Levvroy/LevvDeck/levvdeck-connections.md

# LevvDeck — Connections & Footprints

> Auto-generated by `gen_connections.py` from the shared data block in `gen_netlist.py`. Do not edit by hand — edit the data block and regenerate. The ESP32 pinout here is identical to the `#define`s in `firmware.ino`.

## ESP32 pinout (locked)

| Function | GPIO |
|---|---|
| I2C SDA | IO21 |
| I2C SCL | IO22 |
| Matrix ROW0/1/2 | IO13 / IO14 / IO27 |
| Matrix COL0/1/2 | IO26 / IO25 / IO33 |
| Encoder1 A/B/SW | IO16 / IO17 / IO4 |
| Encoder2 A/B/SW | IO32 / IO18 / IO19 |
| WS2812 DATA | IO23 (via R1) |
| Power | 3V3->OLED VCC, 5V(VIN)->WS2812 VDD, GND common |

## Components / footprints (25 total)

| Ref | Value | Footprint |
|---|---|---|
| D1 | 1N4148 | `Diode_THT:D_DO-35_SOD27_P7.62mm_Horizontal` |
| D2 | 1N4148 | `Diode_THT:D_DO-35_SOD27_P7.62mm_Horizontal` |
| D3 | 1N4148 | `Diode_THT:D_DO-35_SOD27_P7.62mm_Horizontal` |
| D4 | 1N4148 | `Diode_THT:D_DO-35_SOD27_P7.62mm_Horizontal` |
| D5 | 1N4148 | `Diode_THT:D_DO-35_SOD27_P7.62mm_Horizontal` |
| D6 | 1N4148 | `Diode_THT:D_DO-35_SOD27_P7.62mm_Horizontal` |
| D7 | 1N4148 | `Diode_THT:D_DO-35_SOD27_P7.62mm_Horizontal` |
| D8 | 1N4148 | `Diode_THT:D_DO-35_SOD27_P7.62mm_Horizontal` |
| D9 | 1N4148 | `Diode_THT:D_DO-35_SOD27_P7.62mm_Horizontal` |
| J1 | OLED_I2C | `Connector_PinHeader_2.54mm:PinHeader_1x04_P2.54mm_Vertical` |
| LED1 | WS2812B | `LED_SMD:LED_WS2812B_PLCC4_5.0x5.0mm_P3.2mm` |
| LED2 | WS2812B | `LED_SMD:LED_WS2812B_PLCC4_5.0x5.0mm_P3.2mm` |
| R1 | 330 | `Resistor_THT:R_Axial_DIN0207_L6.3mm_D2.5mm_P10.16mm_Horizontal` |
| RV1 | EC11 | `Rotary_Encoder:RotaryEncoder_Alps_EC11E-Switch_Vertical_H20mm` |
| RV2 | EC11 | `Rotary_Encoder:RotaryEncoder_Alps_EC11E-Switch_Vertical_H20mm` |
| SW1 | MX | `Button_Switch_Keyboard:SW_Cherry_MX_1.00u_PCB` |
| SW2 | MX | `Button_Switch_Keyboard:SW_Cherry_MX_1.00u_PCB` |
| SW3 | MX | `Button_Switch_Keyboard:SW_Cherry_MX_1.00u_PCB` |
| SW4 | MX | `Button_Switch_Keyboard:SW_Cherry_MX_1.00u_PCB` |
| SW5 | MX | `Button_Switch_Keyboard:SW_Cherry_MX_1.00u_PCB` |
| SW6 | MX | `Button_Switch_Keyboard:SW_Cherry_MX_1.00u_PCB` |
| SW7 | MX | `Button_Switch_Keyboard:SW_Cherry_MX_1.00u_PCB` |
| SW8 | MX | `Button_Switch_Keyboard:SW_Cherry_MX_1.00u_PCB` |
| SW9 | MX | `Button_Switch_Keyboard:SW_Cherry_MX_1.00u_PCB` |
| U1 | ESP32-DevKitC | `LevvDeck:ESP32_DevKitC_38P_Socket` |

## Matrix (3x3, COL2ROW)

Per key: `SWx.pad1 -> COLn`, `SWx.pad2 -> Dx anode (pad2)`, `Dx cathode (pad1) -> ROWn`.

```
        COL0      COL1      COL2
ROW0    SW1/D1    SW2/D2    SW3/D3
ROW1    SW4/D4    SW5/D5    SW6/D6
ROW2    SW7/D7    SW8/D8    SW9/D9
```

## Nets (29 signal)

| # | Net | Nodes (ref.pad) |
|---|---|---|
| 1 | `+3V3` | U1.3V3, J1.2 |
| 2 | `+5V` | U1.5V, LED1.1, LED2.1 |
| 3 | `GND` | U1.GND, RV1.C, RV1.S2, RV1.MP, RV2.C, RV2.S2, RV2.MP, J1.1, LED1.3, LED2.3 |
| 4 | `I2C_SDA` | U1.IO21, J1.4 |
| 5 | `I2C_SCL` | U1.IO22, J1.3 |
| 6 | `ROW0` | U1.IO13, D1.1, D2.1, D3.1 |
| 7 | `ROW1` | U1.IO14, D4.1, D5.1, D6.1 |
| 8 | `ROW2` | U1.IO27, D7.1, D8.1, D9.1 |
| 9 | `COL0` | U1.IO26, SW1.1, SW4.1, SW7.1 |
| 10 | `COL1` | U1.IO25, SW2.1, SW5.1, SW8.1 |
| 11 | `COL2` | U1.IO33, SW3.1, SW6.1, SW9.1 |
| 12 | `ENC1_A` | U1.IO16, RV1.A |
| 13 | `ENC1_B` | U1.IO17, RV1.B |
| 14 | `ENC1_SW` | U1.IO4, RV1.S1 |
| 15 | `ENC2_A` | U1.IO32, RV2.A |
| 16 | `ENC2_B` | U1.IO18, RV2.B |
| 17 | `ENC2_SW` | U1.IO19, RV2.S1 |
| 18 | `WS_DRIVE` | U1.IO23, R1.1 |
| 19 | `n_SW1_D1` | SW1.2, D1.2 |
| 20 | `n_SW2_D2` | SW2.2, D2.2 |
| 21 | `n_SW3_D3` | SW3.2, D3.2 |
| 22 | `n_SW4_D4` | SW4.2, D4.2 |
| 23 | `n_SW5_D5` | SW5.2, D5.2 |
| 24 | `n_SW6_D6` | SW6.2, D6.2 |
| 25 | `n_SW7_D7` | SW7.2, D7.2 |
| 26 | `n_SW8_D8` | SW8.2, D8.2 |
| 27 | `n_SW9_D9` | SW9.2, D9.2 |
| 28 | `WS_DIN1` | R1.2, LED1.4 |
| 29 | `WS_CHAIN1` | LED1.2, LED2.4 |

_Plus 19 `unconnected-(...)` stub nets — one per floating footprint pad (spare U1 GPIO + LED2 DOUT) — so KiCad's netlist import is warning-free._

## U1 — ESP32 DevKitC socket pad map

> 🛑 **HUMAN CHECK**: row spacing must be measured with calipers; verify this pad order matches YOUR DevKit silk. Footprint `LevvDeck:ESP32_DevKitC_38P_Socket`.

| Pin | Left label | Net | Pin | Right label | Net |
|---|---|---|---|---|---|
| 1 | 3V3 | +3V3 | 20 | GND | GND |
| 2 | EN | — | 21 | IO23 | WS_DRIVE |
| 3 | IO36 | — | 22 | IO22 | I2C_SCL |
| 4 | IO39 | — | 23 | IO1 | — |
| 5 | IO34 | — | 24 | IO3 | — |
| 6 | IO35 | — | 25 | IO21 | I2C_SDA |
| 7 | IO32 | ENC2_A | 26 | GND | GND |
| 8 | IO33 | COL2 | 27 | IO19 | ENC2_SW |
| 9 | IO25 | COL1 | 28 | IO18 | ENC2_B |
| 10 | IO26 | COL0 | 29 | IO5 | — |
| 11 | IO27 | ROW2 | 30 | IO17 | ENC1_B |
| 12 | IO14 | ROW1 | 31 | IO16 | ENC1_A |
| 13 | IO12 | — | 32 | IO4 | ENC1_SW |
| 14 | GND | GND | 33 | IO0 | — |
| 15 | IO13 | ROW0 | 34 | IO2 | — |
| 16 | IO9 | — | 35 | IO15 | — |
| 17 | IO10 | — | 36 | IO8 | — |
| 18 | IO11 | — | 37 | IO7 | — |
| 19 | 5V | +5V | 38 | IO6 | — |

## 🛑 HUMAN CHECK items before fabrication

1. **Diode polarity** — `Dx.pad1` is the **cathode** and must face the ROW net. (Footprint `Diode_THT:D_DO-35_SOD27_P7.62mm_Horizontal`, pad1=K.)
2. **OLED header J1 order** — default is GND/VCC/SCL/SDA (pins 1-4). Confirm against your module's silk; VCC/GND or SCL/SDA order may differ.
3. **EC11 pads** — A/B = quadrature, C = common to GND, S1/S2 = push switch. Confirm against the module.
4. **U1 row spacing + USB edge** — measured spacing, pad mapping, and USB-to-edge cutout all correct.

_WS2812 count: 2._
