Levvroy/LevvDeck/(commit log)

2026-06-30 Add LevvDeck PCB design-as-code pipeline
    Generate the full LevvDeck macropad design (ESP32 + 3x3 Cherry MX matrix,
    2x EC11 encoders, SSD1306 OLED, 2x WS2812B) as a reproducible KiCad pipeline
    the user runs on their KiCad 8/9 machine.
    Single source of truth (gen_netlist.py) drives:
    - levvdeck.net (25 footprints, 29 nets, 0 unresolved)
    - firmware.ino (#define pinout mirrors the netlist)
    - levvdeck-connections.md + levvdeck-BOM.csv
    - custom U1 ESP32-DevKitC socket footprint (parameterized row spacing)
    Pipeline scripts (build_board / place / route / export) + JLCPCB DRC rules,
    Makefile, and BUILD.md with the three HUMAN CHECK gates. Pad names verified
    against the official KiCad libs; corrected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
    [levvdeck-BOM.csv]
2026-07-02 Fix KiCad netlist import: resolve U1 lib + clean warnings
    Two issues surfaced when importing levvdeck.net via KiCad's GUI:
    1. U1 footprint not found. The custom LevvDeck lib is registered only in the
    project fp-lib-table (${KIPRJMOD}), which needs an open KiCad project. Add a
    minimal levvdeck.kicad_pro so the folder is a real project and the table
    resolves LevvDeck:ESP32_DevKitC_38P_Socket. Document the GUI import flow and
    a manual library fallback in BUILD.md.
    2. "no pin X in symbol" warnings for floating pads (LED2 DOUT + spare U1 GPIO).
    gen_netlist.py now declares every footprint pad, placing floating ones on
    their own unconnected-() nets (as KiCad's own netlists do).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
    [gen_connections.py, gen_netlist.py]
